cosinekitty/diodeplot/README.md

# Current/Voltage Plotter

This is a microcontroller project to measure and plot the current/voltage curve for a two-terminal device.
It uses Arduino-based hardware to apply different voltages to a device and measure the current that flows through it. 
The data is captured over the serial monitor and fed through a Python script that plots the graph. 
Here is an example using a 3V Zener diode:

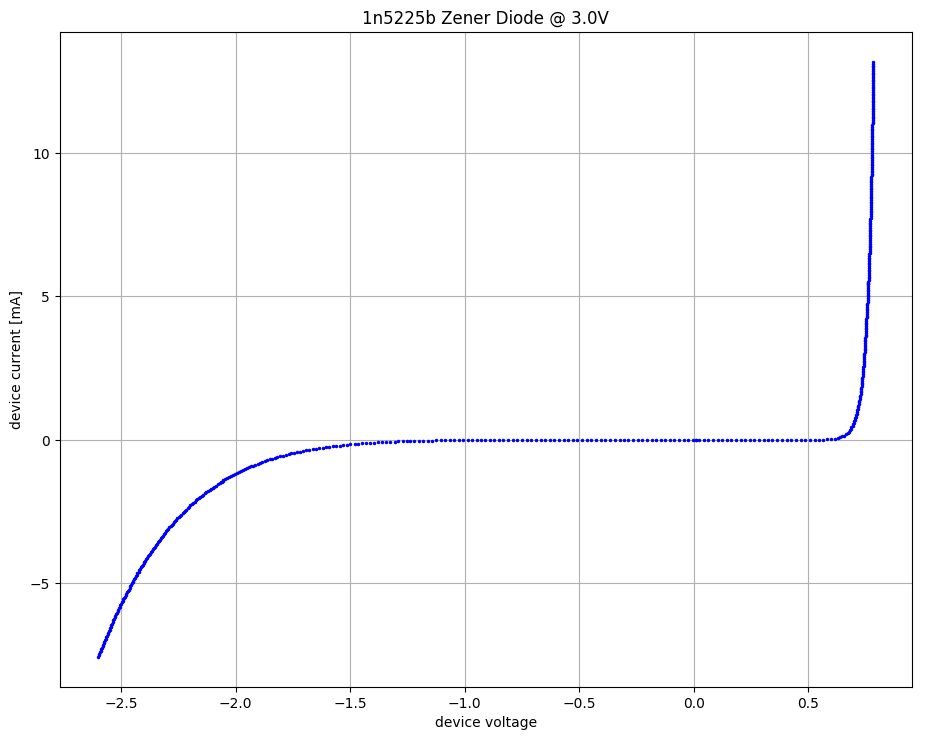
[picture p1: data/zener3v.png]
Zener diode plot


# Curcuit Schematic

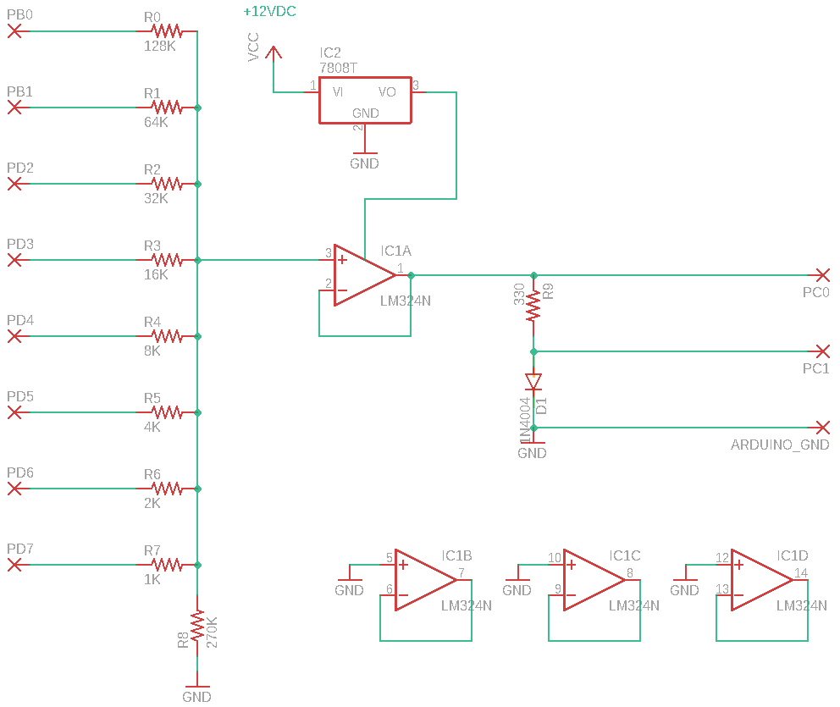
[picture p2: schematics/dac.png]
Circuit schematic


# Read More

See the article I wrote explaining this project:
[Build A Homebrew Current/Voltage Plotter](https://towardsdatascience.com/build-a-homebrew-current-voltage-plotter-88413dfa44d0)
