cosinekitty/diodeplot/schematics/voltage_solution.png

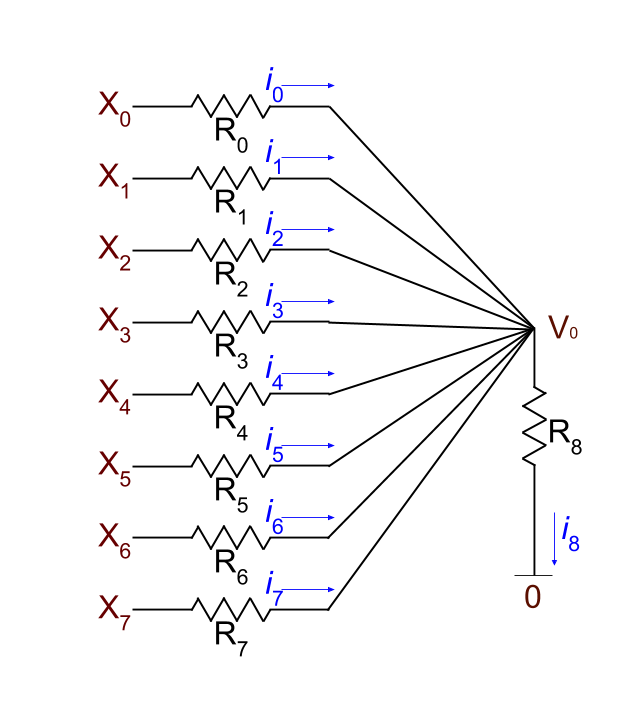
schematics/voltage_solution.png
