cosinekitty/diodeplot/schematics/dac.sch

## EAGLE design schematics/dac.sch (2020-05-31)

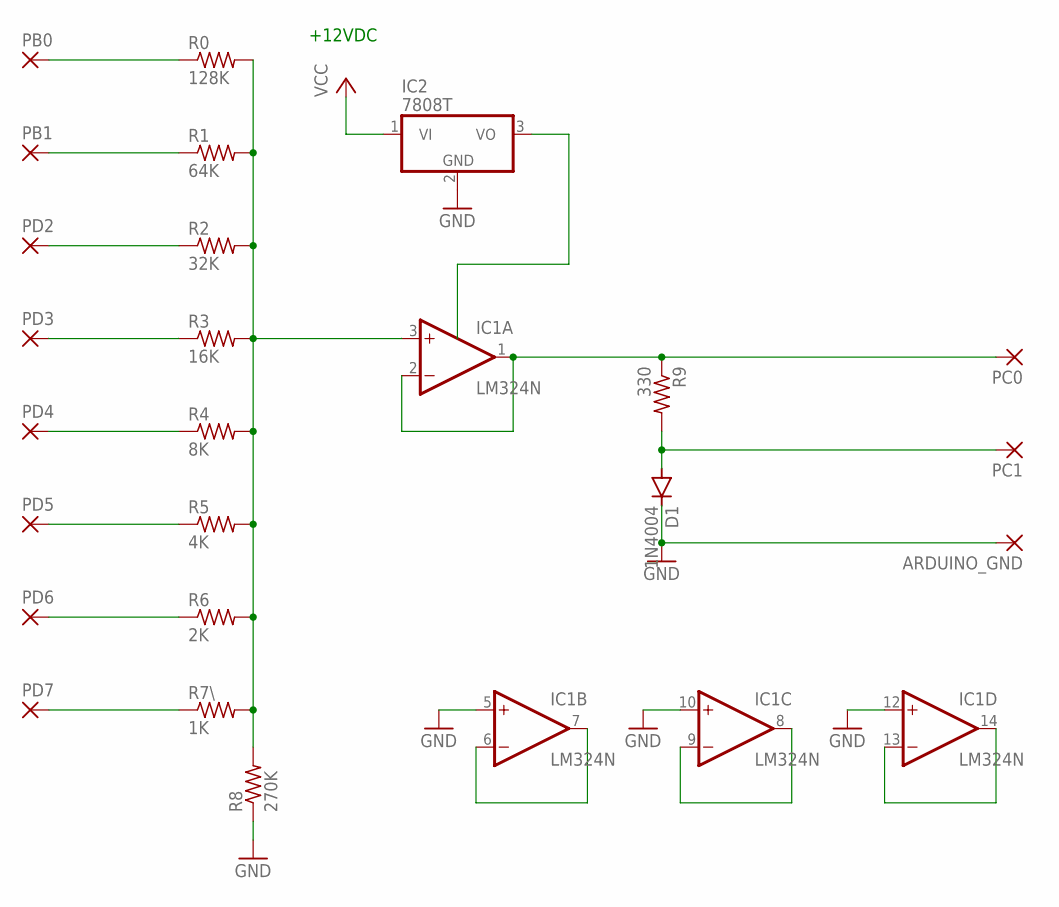
[picture p4: schematic dac.sch]

Parts:
ARDUINO_GND: 1,6/0,8
D1: 1N4004; DO41-10
IC1: LM324N; DIL14
IC2: 7808T; TO220H
PB0, PB1: 1,6/0,8
PC0, PC1: 1,6/0,8
PD2, PD3, PD4, PD5, PD6, PD7: 1,6/0,8
R0: 128K; 0204/7
R1: 64K; 0204/7
R2: 32K; 0204/7
R3: 16K; 0204/7
R4: 8K; 0204/7
R5: 4K; 0204/7
R6: 2K; 0204/7
R7\: 1K; 0204/7
R8: 270K; 0204/7
R9: 330; 0204/7

Connections:
GND: ARDUINO_GND.1, D1.C, IC1.5 (+IN), IC1.10 (+IN), IC1.12 (+IN), IC2.2 (GND), R8.1
unnamed: IC1.3 (+IN), R0.2, R1.2, R2.2, R3.2, R4.2, R5.2, R6.2, R7\.2, R8.2
unnamed: PB0.1, R0.1
unnamed: PB1.1, R1.1
unnamed: PD2.1, R2.1
unnamed: PD3.1, R3.1
unnamed: PD4.1, R4.1
unnamed: PD5.1, R5.1
unnamed: PD6.1, R6.1
unnamed: PD7.1, R7\.1
unnamed: IC1.1 (OUT), IC1.2 (-IN), PC0.1, R9.1
unnamed: IC1.6 (-IN), IC1.7 (OUT)
unnamed: IC1.8 (OUT), IC1.9 (-IN)
unnamed: IC1.13 (-IN), IC1.14 (OUT)
unnamed: D1.A, PC1.1, R9.2
VCC: IC2.1 (VI)

Notes on the sheet:
+12VDC
