cosinekitty/diodeplot/(commit log)

2020-05-27 Starting to write firmware for diode current/voltage plotter.
2020-05-28 Enable full manual control of voltage.
    I needed to calibrate the voltages by measuring them
    with a multimeter while comparing them with the analog readings.
2020-05-28 Script to plot current/voltage data.
2020-05-28 Added data run for a 1K resistor as the test device.
2020-05-28 Modified the hardware design to avoid using TX/RX pins.
    I realized I was using the 2 pins already assigned to
    serial communications, causing incorrect output voltages.
    Now use the bottom 2 pins of PORTB and the top 6 pins of PORTD.
    [DiodePlotFirmware.ino]
2020-05-29 Recaptured data after tuning resistors. Much better!
    Now that I have fixed the wiring problem (no longer
    using TX, RX pins) and I carefully tuned the resistor
    values, I'm getting much cleaner data!
    [DiodePlotFirmware.ino]
2020-05-29 Added multi-sampling support. Refined the voltage model.
    Added support for taking lots of samples and tallying as a histogram.
    This increases precision while reducing the total output size.
    Used linear regression of actual voltage readings to calibrate
    the conversion of analog readings to voltage readings.
2020-05-29 Handle unexpectedly erratic readings from the LED.
    The LED voltage readings are so erratic that I needed to
    widen the histogram window from plus-or-minus 3 to 8.
    Even still, I kept getting failures. So now dynamically
    adjust the center reading as needed, so long as no voltage
    readings have to be discarded.
    [DiodePlotFirmware.ino]
2020-05-29 Make multi-sample output even smaller.
    When there are more than 2 zeroes on the left or right
    of a tally array, we can choose adjust the center up or down by 1
    and delete both zeroes. This makes the output even smaller.
2020-05-29 Ran experiments on more devices.
2020-05-30 Label the graph with x-axis, y-axis, and title.
2020-05-30 Added support for combined forward and reverse bias plotting.
    [DiodePlotFirmware.ino]
2020-05-31 Added DAC schematic: Autodesk Eagle file and PNG image.
    [dac.sch]
2020-05-31 Repeated Zener 3V diode experiment using Windows laptop.
    This was a test that the code works properly when built
    using Windows 10. It also is a test to see that I get
    consistent data when running the test more than once.
2020-05-31 Verify the accumulator makes sense before running a command.
    I ran the command 'm1000' instead of '1000m' and got weird results.
    Then I realized I was using a zero accumulator.
    Added a sanity check that prints an error message when the
    accumulator is not set to a valid value.
    [DiodePlotFirmware.ino]
2020-06-15 Added green LED data.
2020-06-24 model.py: Modified the DiodeCurrent model to get much better curve fit.
